jtmaston/CIMPLC-Firmware/(threads)

Thread 13 (2023-06-11):

Driver: EEPROM

jtmaston, 2023-06-11:

jtmaston, 2023-06-15:
Failed due to: i2c calls are not thread safe!

jtmaston, 2023-06-17:
Moved nack into validation as allegedly idf functions are thread safe. Some mechanism to lock an external mutex is needed though!

Closed 2024-09-03.

Thread 16 (2023-06-11):

Driver: CAN

jtmaston, 2023-06-11:

jtmaston, 2023-06-18:
Abandoned due to hardware design error

Closed 2023-06-18.
