jtmaston/CIMPLC-Firmware/main/modules/uart.hpp

//
// Created by Alexandru Anastasiu on 1/29/23.
//

#ifndef SERIALTEST_SERIALINIT_HPP
#define SERIALTEST_SERIALINIT_HPP

#include <driver/uart.h>
#include <driver/gpio.h>
#include <init/commonComponents.hpp>

void initializeSerialPorts();

#endif //SERIALTEST_SERIALINIT_HPP
