jtmaston/CIMPLC-Firmware/(commit log)

2023-04-22 Remove some garbage
    [opampin.kicad_pcb, opampin.kicad_sch]
2023-04-22 # Title: Summary, imperative, start upper case, don't end with a period # No more than 50 chars. #### 50 chars is here: # Prepping repo
    # Remember blank line between title and body.
    # Body: Explain *what* and *why* (not *how*). Include task ID (Jira issue).
    # Wrap at 72 chars. ################################## which is here: #
    Deleted lib files that did not belong to KiCAD
    Altered project paths to be referenced to local project, ensuring portability
    # At the end: Include Co-authored-by for all contributors.
    # Include at least one empty line before it. Format:
    # Co-authored-by: name <user@users.noreply.github.com>
    [IO_Block.kicad_sch, IO_Block_1.kicad_sch, I_Block.kicad_sch, PLC-CIM.kicad_sch, PM.kicad_sch]
2023-04-22 Revert "# Title: Summary, imperative, start upper case, don't end with a period"
    This reverts commit 68e2e82ae65b044d3f55e91a7adcee939c25789e.
    [IO_Block.kicad_sch, IO_Block_1.kicad_sch, I_Block.kicad_sch, PLC-CIM.kicad_sch, PM.kicad_sch]
2023-04-22 Revert "Revert "# Title: Summary, imperative, start upper case, don't end with a period""
    This reverts commit 3a20dd9da141c7cb1bae8077342d3450242b15f5.
    [IO_Block.kicad_sch, IO_Block_1.kicad_sch, I_Block.kicad_sch, PLC-CIM.kicad_sch, PM.kicad_sch]
2023-04-23 Finalized generalized design
    [IO_Block_1.kicad_sch, I_Block.kicad_sch, PLC-CIM.kicad_sch, RS232.kicad_sch, lp_uart_block.kicad_sch]
2023-04-23 Redesigned, to utilize the ESP32 as the basis
    * Implemented EEPROM
    * Implemented RTC
    * Implemented RS232 and 485
    * Implemented CANBus
    * Implemented everything
    [CanXCIEVER.kicad_sch, EEPROM.kicad_sch, IO_Block.kicad_sch, IO_Block_1.kicad_sch, I_Block.kicad_sch, PLC-CIM.kicad_sch, PM.kicad_sch, RS232.kicad_sch]
2023-04-23 Implemented Output block in PCB Started implementation of Input block in PCB
    [EEPROM.kicad_sch, IO_Block_1.kicad_sch, I_Block.kicad_sch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]
2023-04-25 Finalized PCB
    [EEPROM.kicad_sch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]
2023-05-06 Add partition tables
    [partitionMap.csv]
2023-05-08 Added improvements towards bootloader stub size
    [partitionMap.csv]
2023-05-10 Finalized partitioning
    [CanXCIEVER.kicad_sch, EEPROM.kicad_sch, IO_Block.kicad_sch, IO_Block_1.kicad_sch, I_Block.kicad_sch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]
2023-05-10 Actually set partitions right
    [partitionMap.csv]
2023-05-14 Completed bootloaderStub, with full(tm) functionality * Un-minified the HTML * Disabled all prints * Disabled NVS * Added some additional error checking * Increased the chunk size, but discovered tha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
    [partitionMap.csv]
2023-05-14 Fixed a bug that caused incorrect uploads
    [main.cpp]
2023-05-14 Added Powershell script as export target
2023-05-22 Cleaned up repo * Removed most legacy functions that would not be used * Removed confusing http module * Removed OTA reboot checking, since only one OTA partition will be used * Moved reboot counters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
    [partitionMap.csv]
2023-05-22 Bugfixes * Fixed some remnants of eeprom support
    [main.cpp]
2023-06-09 Worky :)
    * Implemented eeprom functionality
    [CanXCIEVER.kicad_sch, EEPROM.kicad_sch, IO_Block.kicad_sch, IO_Block_1.kicad_sch, I_Block.kicad_sch, PLC-CIM.kicad_sch, PM.kicad_sch, RS232.kicad_sch]
2023-06-10 Remove hardware from the repo
    [CanXCIEVER.kicad_sch, EEPROM.kicad_sch, IO_Block.kicad_sch, IO_Block_1.kicad_sch, I_Block.kicad_sch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]
2023-06-11 Add workflow and partitionMap
    [partitionMap.csv]
